b00m-in/layout-pwr-supply/shots/IMG_20201220_165415.jpg

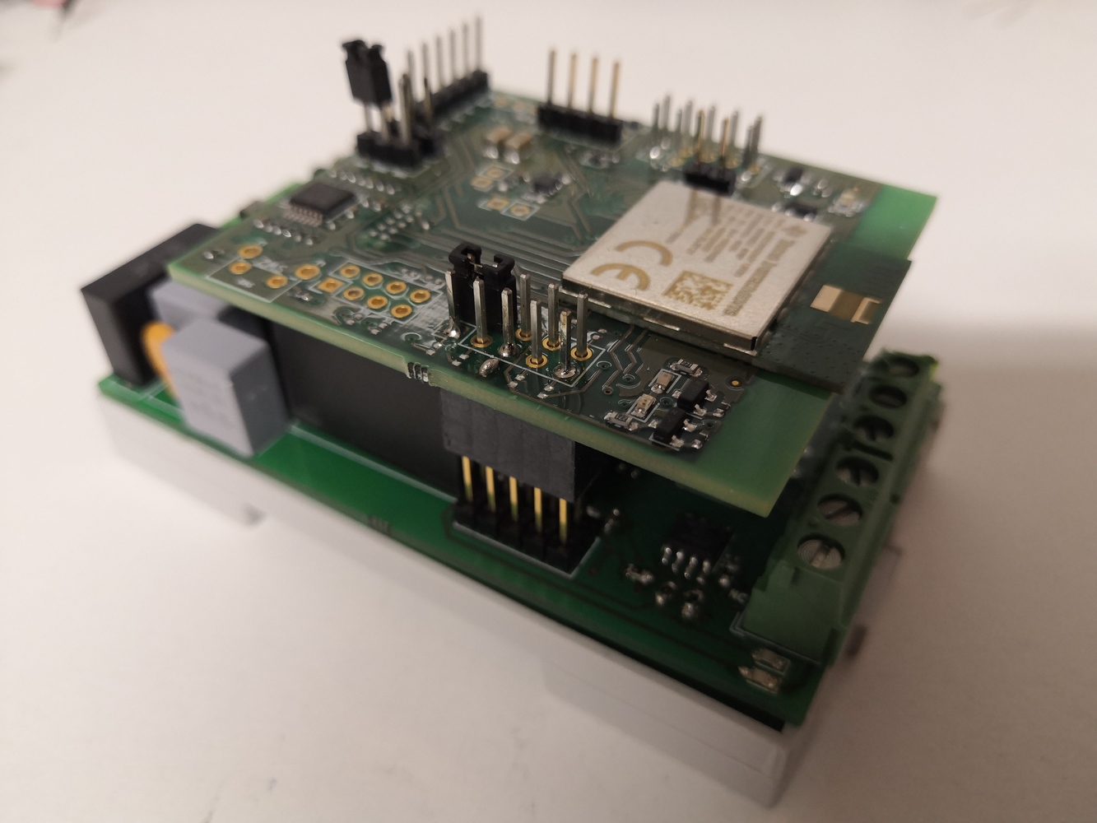
shots/IMG_20201220_165415.jpg
