b00m-in/layout-pwr-supply/(commit log)

2020-10-06 Added missing 5VDC connection to isolator (isow7841dwe) and created new net vcc between isolator and esd/transceiver(thvd1500d). Changed layout.
    [pwrcon_1.kicad_pcb, pwrcon_1.sch]
2020-10-12 Headers should now match cc3220modasf commit d3c2dc17dd42c882b5c02795b58cb5e5026f240b
    [pwrcon_1.kicad_pcb, pwrcon_1.sch]
2021-05-10 State at time of 2021-11-25 Aisler order
    [pwrcon_1.kicad_pcb, pwrcon_1.sch]
